bootsector/kbd2snes/README.md

# kbd2snes
PS/2 keyboard to Super Nintendo Adapter

http://www.brunofreitas.com/node/71
