bootsector/kbd2snes/board/kbd2snes.brd

## EAGLE design board/kbd2snes.brd (2016-02-12)

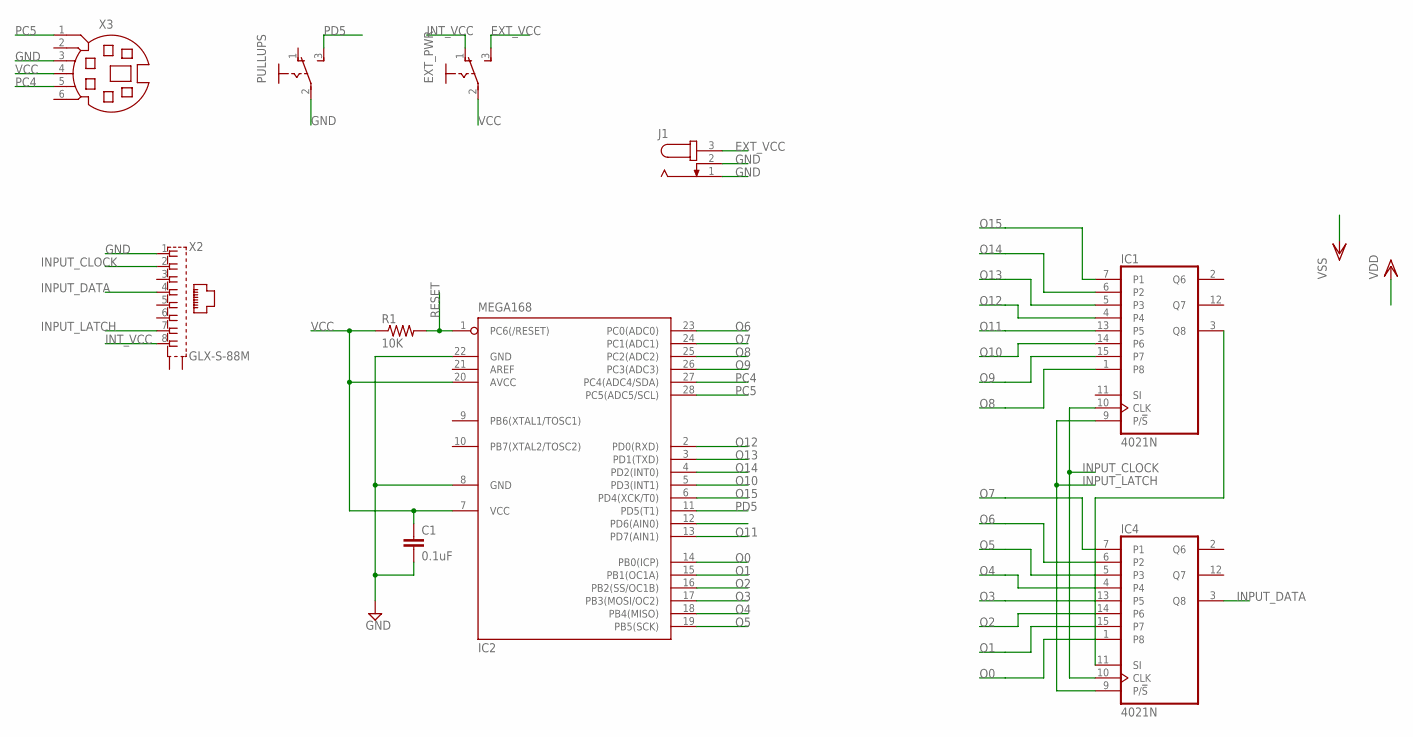
[picture p1: schematic kbd2snes.sch]

Parts:
C1: 0.1uF; C050-024X044
EXT_PWR: CHAVE
IC1, IC4: 4021N; DIL16
IC2: MEGA168; DIL28-3
J1: JACK-PLUG1; SPC4078
PULLUPS: CHAVE
R1: 10K; 0207/7
X2: GLX-S-88M
X3: MD06SS; MDIN06SS

Connections:
EXT_VCC: EXT_PWR.3 (S), J1.3
GND: C1.2, IC1.8 (VSS), IC2.8 (GND), IC2.22 (GND), IC4.8 (VSS), J1.1, J1.2, PULLUPS.2, X2.1, X3.3
INPUT_CLOCK: IC1.10 (CLK), IC4.10 (CLK), X2.2
INPUT_DATA: IC4.3 (Q8), X2.4
INPUT_LATCH: IC1.9 (P/!S), IC4.9 (P/!S), X2.7
INT_VCC: EXT_PWR.1 (O), X2.8
unnamed: IC1.3 (Q8), IC4.11 (SI)
O0: IC2.14 (PB0(ICP)), IC4.1 (P8)
O1: IC2.15 (PB1(OC1A)), IC4.15 (P7)
O2: IC2.16 (PB2(SS/OC1B)), IC4.14 (P6)
O3: IC2.17 (PB3(MOSI/OC2)), IC4.13 (P5)
O4: IC2.18 (PB4(MISO)), IC4.4
O5: IC2.19 (PB5(SCK)), IC4.5 (P3)
O6: IC2.23 (PC0(ADC0)), IC4.6 (P2)
O7: IC2.24 (PC1(ADC1)), IC4.7 (P1)
O8: IC1.1 (P8), IC2.25 (PC2(ADC2))
O9: IC1.15 (P7), IC2.26 (PC3(ADC3))
O10: IC1.14 (P6), IC2.5 (PD3(INT1))
O11: IC1.13 (P5), IC2.13 (PD7(AIN1))
O12: IC1.4, IC2.2 (PD0(RXD))
O13: IC1.5 (P3), IC2.3 (PD1(TXD))
O14: IC1.6 (P2), IC2.4 (PD2(INT0))
O15: IC1.7 (P1), IC2.6 (PD4(XCK/T0))
PC4: IC2.27 (PC4(ADC4/SDA)), X3.5
PC5: IC2.28 (PC5(ADC5/SCL)), X3.1
PD5: IC2.11 (PD5(T1)), PULLUPS.3 (S)
RESET: IC2.1 (PC6(/RESET)), R1.2
VCC: C1.1, EXT_PWR.2, IC1.16 (VDD), IC2.7 (VCC), IC2.20 (AVCC), IC4.16 (VDD), R1.1, X3.4

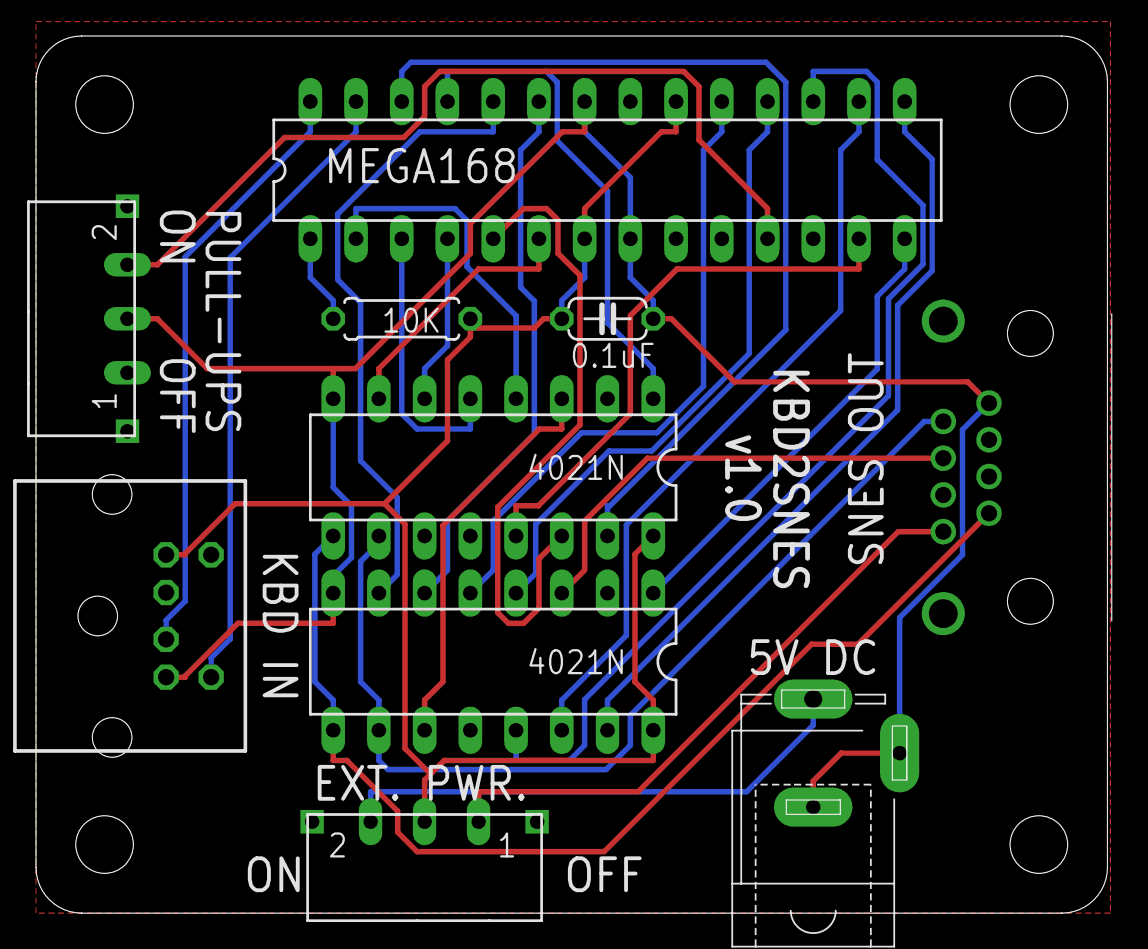
[picture p2: board kbd2snes.brd from above]

Board: 2 copper layers, 59.5 x 48.7 mm, 10 parts (0 on the bottom side), 28 nets.
