bootsector/kbd2snes/main.c

/*
 * KBD2SNES - PS/2 Keyboard Adapter for SNES
 * Copyright (c) 2016 Bruno Freitas - bruno@brunofreitas.com
 *
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
 * You should have received a copy of the GNU General Public License
 * along with this program.  If not, see <http://www.gnu.org/licenses/>.
 */

#include "kbdhandler.h"

int main(void)
{
	keyboard_init();

	for(;;) {
		while(!keyboard_has_data());

		uint8_t key = keyboard_get_data();

		keyboard_handle_key(key);
	}

	return 0;
}
