bootsector/kbd2snes/kbdhandler.c

/*
 * KBD2SNES - PS/2 Keyboard Adapter for SNES
 * Copyright (c) 2016 Bruno Freitas - bruno@brunofreitas.com
 *
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
 * You should have received a copy of the GNU General Public License
 * along with this program.  If not, see <http://www.gnu.org/licenses/>.
 */
#include <avr/pgmspace.h>

#include "kbdhandler.h"
#include "snes.h"
#include "kbd.h"

#define NUM_KBD_PROFILES 2

// Profile template (all 256 positions as SNES_NO_ACTION):
// {SNES_NO_ACTION, SNES_NO_ACTION, SNES_NO_ACTION, SNES_NO_ACTION, SNES_NO_ACTION, SNES_NO_ACTION, SNES_NO_ACTION, SNES_NO_ACTION, SNES_NO_ACTION, SNES_NO_ACTION, SNES_NO_ACTION, SNES_NO_ACTION, SNES_NO_ACTION, SNES_NO_ACTION, SNES_NO_ACTION, SNES_NO_ACTION, SNES_NO_ACTION, SNES_NO_ACTION, SNES_NO_ACTION, SNES_NO_ACTION, SNES_NO_ACTION, SNES_NO_ACTION, SNES_NO_ACTION, SNES_NO_ACTION, SNES_NO_ACTION, SNES_NO_ACTION, SNES_NO_ACTION, SNES_NO_ACTION, SNES_NO_ACTION, SNES_NO_ACTION, SNES_NO_ACTION, SNES_NO_ACTION, SNES_NO_ACTION, SNES_NO_ACTION, SNES_NO_ACTION, SNES_NO_ACTION, SNES_NO_ACTION, SNES_NO_ACTION, SNES_NO_ACTION, SNES_NO_ACTION, SNES_NO_ACTION, SNES_NO_ACTION, SNES_NO_ACTION, SNES_NO_ACTION, SNES_NO_ACTION, SNES_NO_ACTION, SNES_NO_ACTION, SNES_NO_ACTION, SNES_NO_ACTION, SNES_NO_ACTION, SNES_NO_ACTION, SNES_NO_ACTION, SNES_NO_ACTION, SNES_NO_ACTION, SNES_NO_ACTION, SNES_NO_ACTION, SNES_NO_ACTION, SNES_NO_ACTION, SNES_NO_ACTION, SNES_NO_ACTION, SNES_NO_ACTION, SNES_NO_ACTION, SNES_NO_ACTION, SNES_NO_ACTION, SNES_NO_ACTION, SNES_NO_ACTION, SNES_NO_ACTION, SNES_NO_ACTION, SNES_NO_ACTION, SNES_NO_ACTION, SNES_NO_ACTION, SNES_NO_ACTION, SNES_NO_ACTION, SNES_NO_ACTION, SNES_NO_ACTION, SNES_NO_ACTION, SNES_NO_ACTION, SNES_NO_ACTION, SNES_NO_ACTION, SNES_NO_ACTION, SNES_NO_ACTION, SNES_NO_ACTION, SNES_NO_ACTION, SNES_NO_ACTION, SNES_NO_ACTION, SNES_NO_ACTION, SNES_NO_ACTION, SNES_NO_ACTION, SNES_NO_ACTION, SNES_NO_ACTION, SNES_NO_ACTION, SNES_NO_ACTION, SNES_NO_ACTION, SNES_NO_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
NO_ACTION, SNES_NO_ACTION, SNES_NO_ACTION, SNES_NO_ACTION, SNES_NO_ACTION, SNES_NO_ACTION, SNES_NO_ACTION, SNES_NO_ACTION, SNES_NO_ACTION, SNES_NO_ACTION, SNES_NO_ACTION, SNES_NO_ACTION, SNES_NO_ACTION, SNES_NO_ACTION, SNES_NO_ACTION, SNES_NO_ACTION, SNES_NO_ACTION, SNES_NO_ACTION, SNES_NO_ACTION, SNES_NO_ACTION, SNES_NO_ACTION, SNES_NO_ACTION, SNES_NO_ACTION, SNES_NO_ACTION, SNES_NO_ACTION, SNES_NO_ACTION, SNES_NO_ACTION, SNES_NO_ACTION, SNES_NO_ACTION, SNES_NO_ACTION, SNES_NO_ACTION, SNES_NO_ACTION, SNES_NO_ACTION, SNES_NO_ACTION, SNES_NO_ACTION, SNES_NO_ACTION, SNES_NO_ACTION, SNES_NO_ACTION, SNES_NO_ACTION, SNES_NO_ACTION, SNES_NO_ACTION, SNES_NO_ACTION, SNES_NO_ACTION, SNES_NO_ACTION, SNES_NO_ACTION, SNES_NO_ACTION, SNES_NO_ACTION, SNES_NO_ACTION, SNES_NO_ACTION, SNES_NO_ACTION, SNES_NO_ACTION, SNES_NO_ACTION, SNES_NO_ACTION, SNES_NO_ACTION, SNES_NO_ACTION, SNES_NO_ACTION, SNES_NO_ACTION, SNES_NO_ACTION, SNES_NO_ACTION, SNES_NO_ACTION, SNES_NO_ACTION, SNES_NO_ACTION, SNES_NO_ACTION, SNES_NO_ACTION, SNES_NO_ACTION, SNES_NO_ACTION, SNES_NO_ACTION, SNES_NO_ACTION, SNES_NO_ACTION},
};

static int kbd_extended_flag = 0;
static int kbd_key_profile = 0;

void keyboard_init(void) {
	snes_init();

	kbd_init();
}

uint8_t keyboard_has_data(void) {
	return kbd_rb_hasitem();
}

uint8_t keyboard_get_data(void) {
	return kbd_rb_get();
}

static void keyboard_ignore_next_keys(int keys) {
	while(keys--) {
		while(!kbd_rb_hasitem());

		kbd_rb_get();
	}
}

static void keyboard_make(uint8_t key) {
	if(kbd_extended_flag) {
		switch(key) {
			case 0x12: // PRNT SCRN (Make) E0,12,E0,7C
				keyboard_ignore_next_keys(2);
				break;
			default:
				snes_press(pgm_read_byte(&ext_keys_lut[kbd_key_profile][key]));
		}
	} else {
		switch(key) {
			case 0x05: // F1 - Rotate between keyboard profiles
				snes_reset_output();
				kbd_key_profile = (kbd_key_profile + 1) % NUM_KBD_PROFILES;
				break;
			default:
				snes_press(pgm_read_byte(&keys_lut[kbd_key_profile][key]));
		}
	}
}

static void keyboard_break(void) {
	while(!kbd_rb_hasitem());

	uint8_t key = kbd_rb_get();

	if(kbd_extended_flag) {
		switch(key) {
			case 0x7C: // PRNT SCRN (Break) E0,F0,7C,E0,F0,12
				keyboard_ignore_next_keys(3);
				break;
			default:
				snes_release(pgm_read_byte(&ext_keys_lut[kbd_key_profile][key]));
		}

	} else {
		switch(key) {
			case 0x05: // F1 key release. Do nothing!
				snes_release(SNES_NO_ACTION);
				break;
			default:
				snes_release(pgm_read_byte(&keys_lut[kbd_key_profile][key]));
		}
	}
}

static void keyboard_extended(void) {
	while(!kbd_rb_hasitem());

	kbd_extended_flag = 1;

	uint8_t key = kbd_rb_get();

	switch(key) {
		case 0xF0:
			keyboard_break();
			break;
		default:
			keyboard_make(key);
			break;
	}
}

void keyboard_handle_key(uint8_t key) {
	kbd_extended_flag = 0;

	switch(key) {
		case 0xF0:
			keyboard_break();
			break;
		case 0xE0:
			keyboard_extended();
			break;
		case 0xE1: // PAUSE (Make) E1,14,77,E1,F0,14,F0,77
			keyboard_ignore_next_keys(7);
			break;
		default:
			keyboard_make(key);
			break;
	}
}
