bootsector/kbd2snes/(commit log)

2016-02-11 Keyboard reading driver. Tests pending...
2016-02-11 Added snes output driver
2016-02-12 Initial tests passed. It does not seem to work under 3.3v
2016-02-12 Added board Eagle files
    [kbd2snes.brd, kbd2snes.sch]
2016-02-12 Fixed kbd profiles. Added a new profile. Added support to profile selection by pressing F1 key
    [kbdhandler.c]
2016-02-12 Reset SNES output when switching keyboard input profiles
    [kbdhandler.c, snes.c, snes.h]
2016-02-16 Refactoring - Added ringbuffer.c as part of the keyboard driver - kbd.c
2016-02-17 Added pullup on-off switch control
